Kante1702/dual-axis-light-tracker/firmware/sledovac_svetla/sledovac_svetla.ioc

Mcu.UserName=STM32F303K8Tx
PA0.GPIO_Label=LDR_LH
PA0.Signal=ADC1_IN1
PA1.GPIO_Label=LDR_PH
PA1.Signal=ADC1_IN2
PA12.GPIO_Label=BTN
PA12.Signal=GPXTI12
PA13.GPIO_Label=SWDIO
PA13.Signal=SYS_JTMS-SWDIO
PA14.GPIO_Label=SWCLK
PA14.Signal=SYS_JTCK-SWCLK
PA15.GPIO_Label=VCP_RX
PA15.Signal=USART2_RX
PA2.GPIO_Label=VCP_TX
PA2.Signal=USART2_TX
PA3.GPIO_Label=LDR_LD
PA3.Signal=ADC1_IN4
PB0.GPIO_Label=LDR_PD
PB0.Signal=ADC1_IN11
PB1.GPIO_Label=SERVO_LAMP
PB1.Signal=S_TIM3_CH4
PB3.GPIO_Label=LED
PB3.Signal=GPIO_Output
PB4.GPIO_Label=SERVO_PAN
PB4.Signal=S_TIM3_CH1
PB5.GPIO_Label=SERVO_TILT
PB5.Signal=S_TIM3_CH2
PB6.GPIO_Label=INA_SCL
PB6.Signal=I2C1_SCL
PB7.GPIO_Label=INA_SDA
PB7.Signal=I2C1_SDA
