Kante1702/dual-axis-light-tracker/firmware/sledovac_svetla/Core/Inc/main.h

#define LDR_LH_Pin LL_GPIO_PIN_0
#define LDR_LH_GPIO_Port GPIOA
#define LDR_PH_Pin LL_GPIO_PIN_1
#define LDR_PH_GPIO_Port GPIOA
#define VCP_TX_Pin LL_GPIO_PIN_2
#define VCP_TX_GPIO_Port GPIOA
#define LDR_LD_Pin LL_GPIO_PIN_3
#define LDR_LD_GPIO_Port GPIOA
#define LDR_PD_Pin LL_GPIO_PIN_0
#define LDR_PD_GPIO_Port GPIOB
#define SERVO_LAMP_Pin LL_GPIO_PIN_1
#define SERVO_LAMP_GPIO_Port GPIOB
#define BTN_Pin LL_GPIO_PIN_12
#define BTN_GPIO_Port GPIOA
#define BTN_EXTI_IRQn EXTI15_10_IRQn
#define SWDIO_Pin LL_GPIO_PIN_13
#define SWDIO_GPIO_Port GPIOA
#define SWCLK_Pin LL_GPIO_PIN_14
#define SWCLK_GPIO_Port GPIOA
#define VCP_RX_Pin LL_GPIO_PIN_15
#define VCP_RX_GPIO_Port GPIOA
#define LED_Pin LL_GPIO_PIN_3
#define LED_GPIO_Port GPIOB
#define SERVO_PAN_Pin LL_GPIO_PIN_4
#define SERVO_PAN_GPIO_Port GPIOB
#define SERVO_TILT_Pin LL_GPIO_PIN_5
#define SERVO_TILT_GPIO_Port GPIOB
#define INA_SCL_Pin LL_GPIO_PIN_6
#define INA_SCL_GPIO_Port GPIOB
#define INA_SDA_Pin LL_GPIO_PIN_7
#define INA_SDA_GPIO_Port GPIOB
#define NVIC_PRIORITYGROUP_0         ((uint32_t)0x00000007) /*!< 0 bit  for pre-emption priority,
#define NVIC_PRIORITYGROUP_1         ((uint32_t)0x00000006) /*!< 1 bit  for pre-emption priority,
#define NVIC_PRIORITYGROUP_2         ((uint32_t)0x00000005) /*!< 2 bits for pre-emption priority,
#define NVIC_PRIORITYGROUP_3         ((uint32_t)0x00000004) /*!< 3 bits for pre-emption priority,
#define NVIC_PRIORITYGROUP_4         ((uint32_t)0x00000003) /*!< 4 bits for pre-emption priority,
