Kante1702/dual-axis-light-tracker/(notices)

Notices in the files:
firmware/sledovac_svetla/Core/Inc/main.h:
Copyright (c) 2026 STMicroelectronics.
All rights reserved.
This software is licensed under terms that can be found in the LICENSE file
